CrossRoadLAB/DMX-Smoke-Machine-Converter/PCB/Smoke-machine-DMX-converter.csv

ID | Name | Designator | Quantity | Manufacturer Part
1 | 0.1u | C1,C2 | 2
2 | Header-Male-2.54_1x3 | H1 | 1 | 2.54-1*3P针
3 | 1k | R1 | 1
4 | 330 | R2 | 1
5 | 4.7k | R3 | 1
6 | ESP32C3-SUPERMINI | U1 | 1 | ESP32C3-SuperMini
7 | XLR-09W-P | U2 | 1 | XLR-09W-P
8 | MAX485EPA-TUDI | U3 | 1 | MAX485EPA-TUDI
9 | HT-6N137 | U4 | 1 | HT-6N137
10 | B0505S-1WL | U5 | 1 | B0505S-1WL
11 | 2.54mm 1*2P | P1 | 1 | 2.54mm 1*2P
12 | 120 | R4 | 1
