CrossRoadLAB/DMX-Smoke-Machine-Converter/(notices)

Notices in the files:
README.md:
License: MIT
